kks3851/PortableWebcam/Case Design/Top.JPG

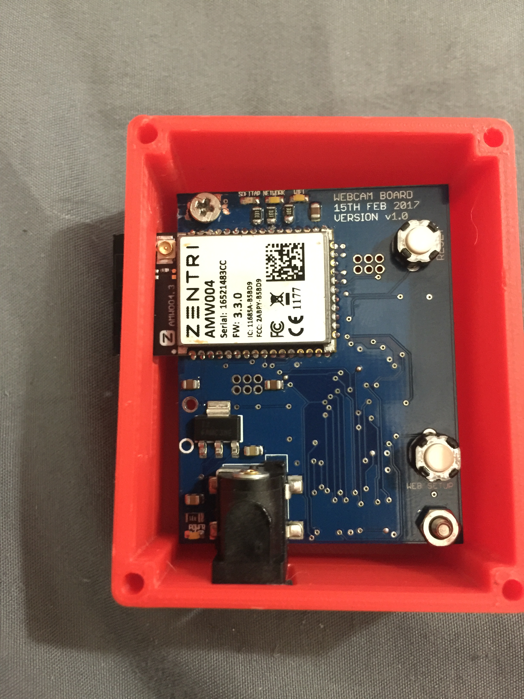
Case Design/Top.JPG
