kks3851/PortableWebcam/Case Design/Bottom.JPG

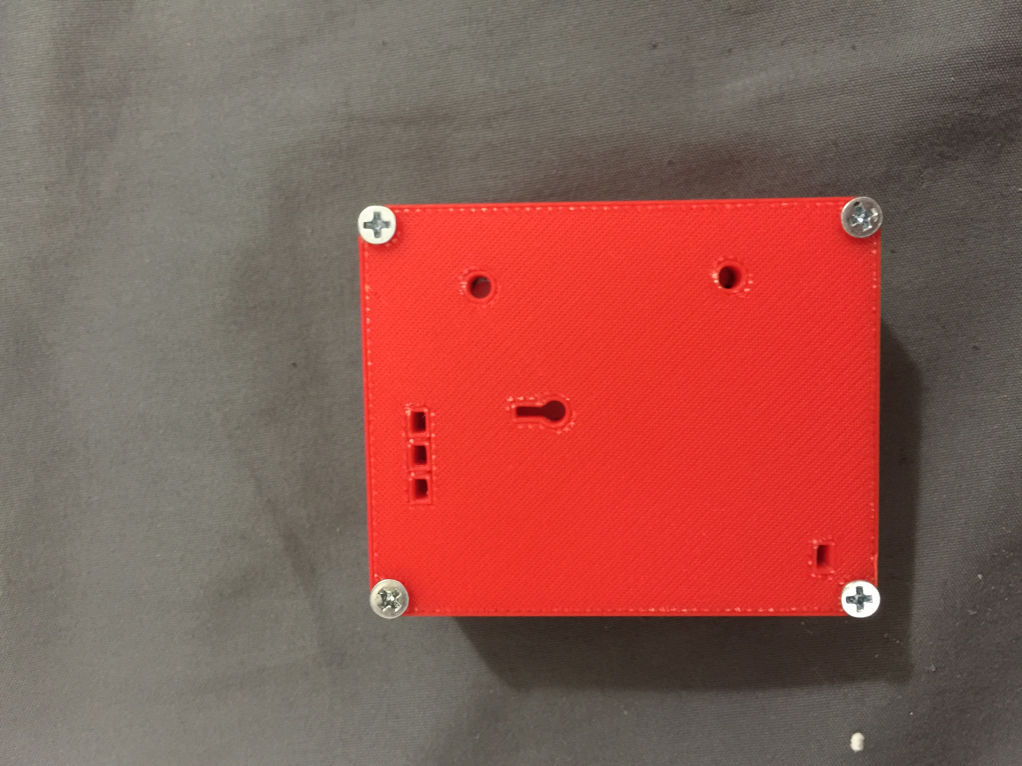
Case Design/Bottom.JPG
