kks3851/PortableWebcam/README.md

# Portable - Webcam 

Portable Webcam linked to Internet using an inbuilt Wi-Fi Chip.
Project Made in EECS 495 - Engineering System Design 1, Winter 2017 at Northwestern University
