kks3851/PortableWebcam/Case Design/README.md

# Webcam Case Design 

Link for Onshape Document:
 https://cad.onshape.com/documents/7c100547b8459ac387640f2b/w/80774a75e7c412339340bdad/e/8ed0149f628bb7e967f2e0de
