kks3851/PortableWebcam/Case Design/Case.JPG

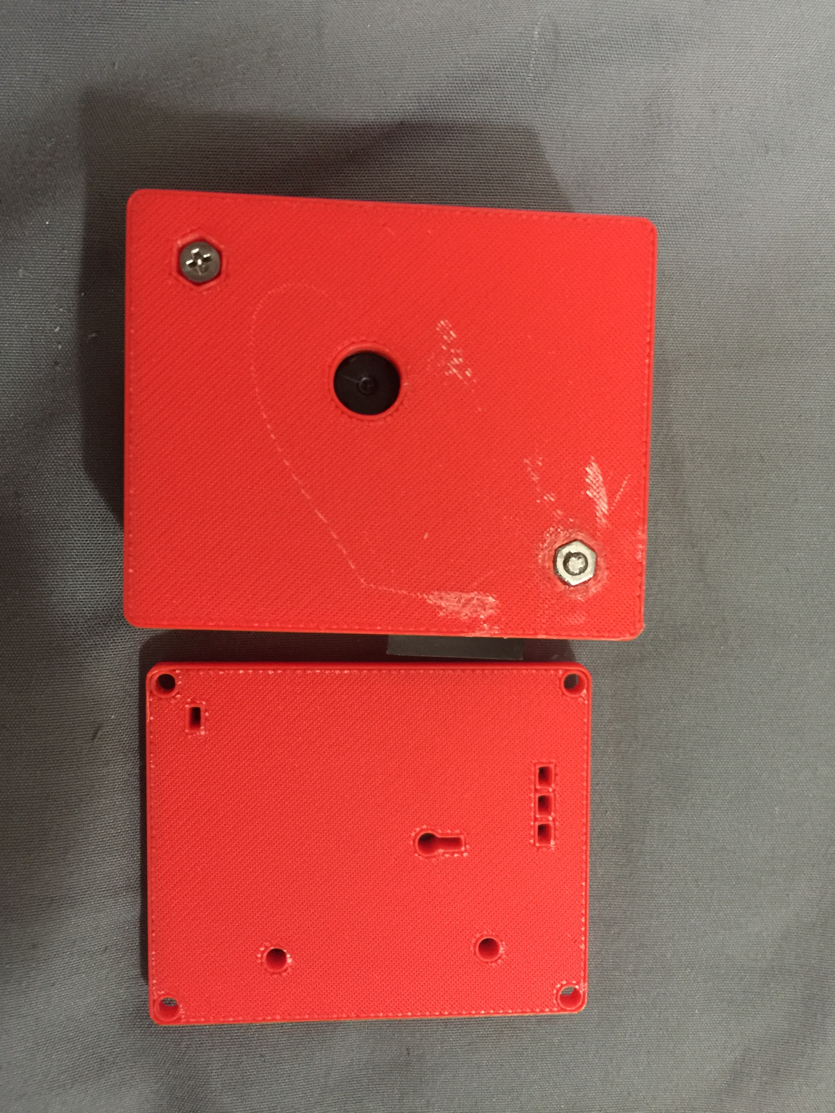
Case Design/Case.JPG
