kks3851/PortableWebcam/Case Design/Left Side.JPG

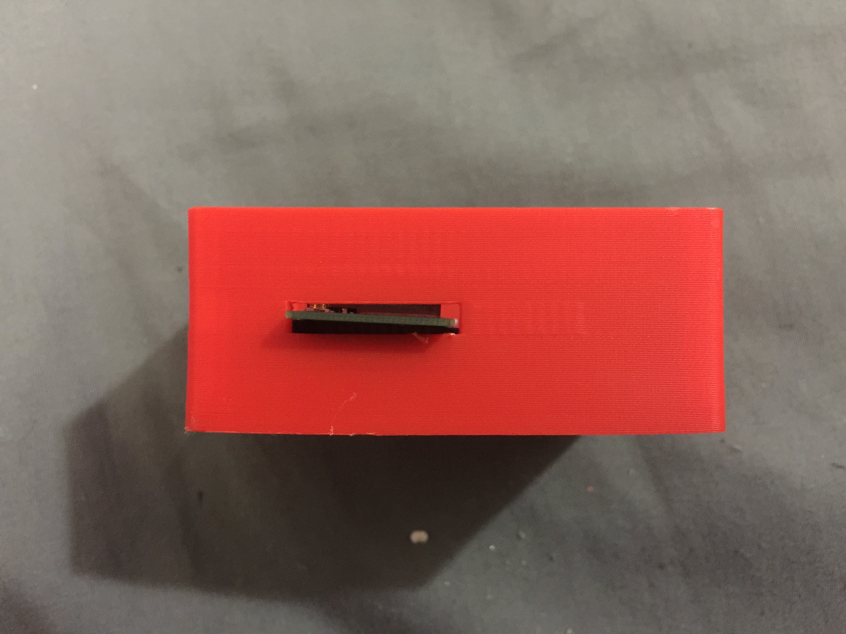
Case Design/Left Side.JPG
