kks3851/PortableWebcam/Case Design/Right Side.JPG

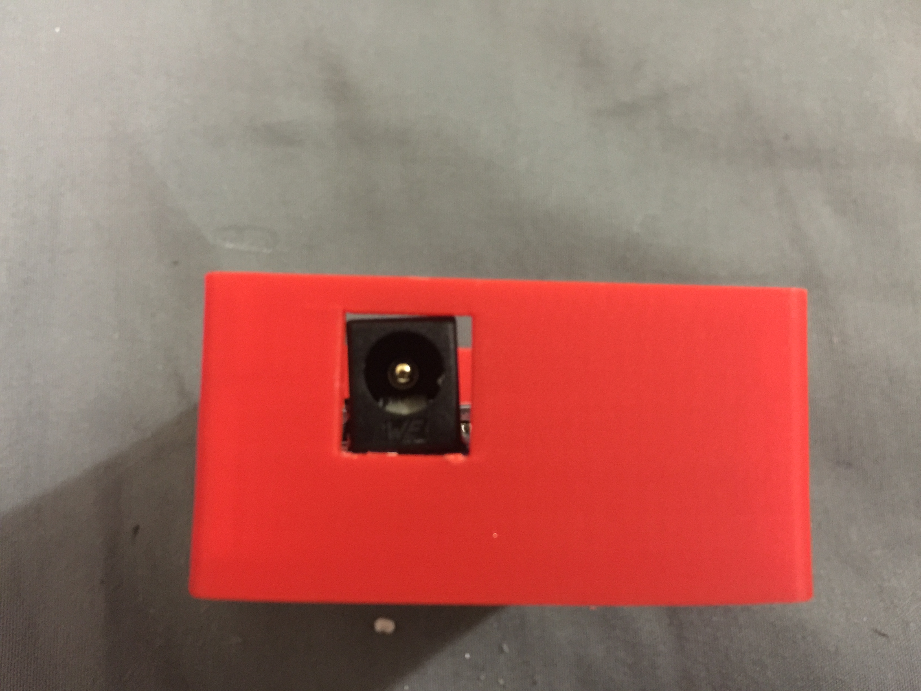
Case Design/Right Side.JPG
